MOARbots/MOARbots-parts/Compound-Gear-Cart/motorassembly.jpg

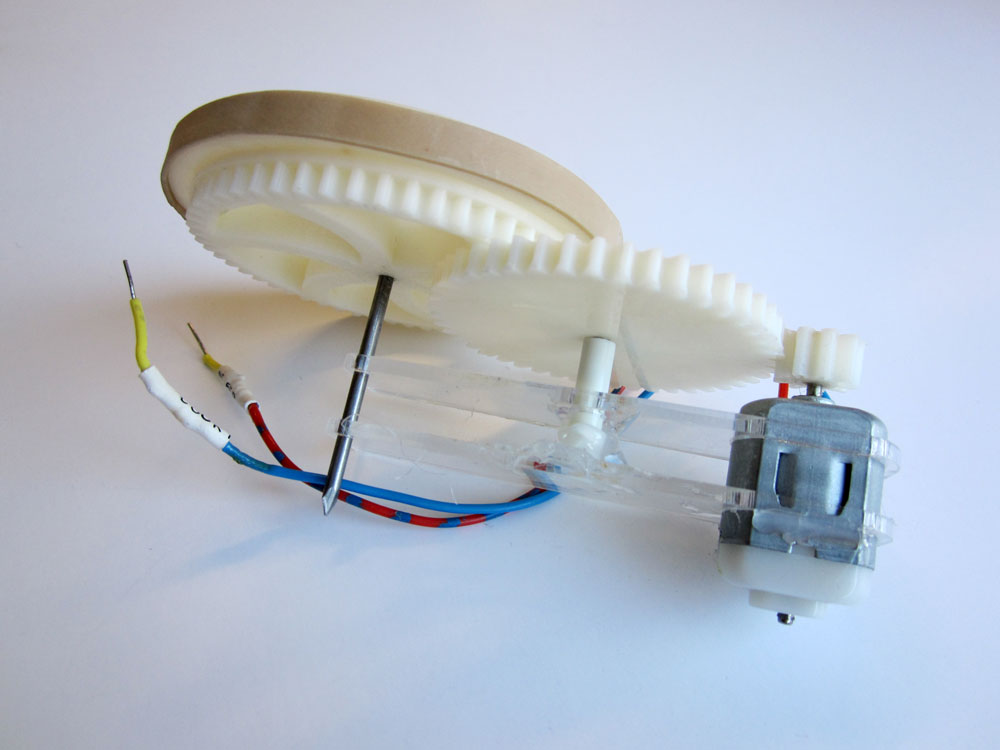
Compound-Gear-Cart/motorassembly.jpg
