MOARbots/MOARbots-parts/Compound-Gear-Cart/parts.jpg

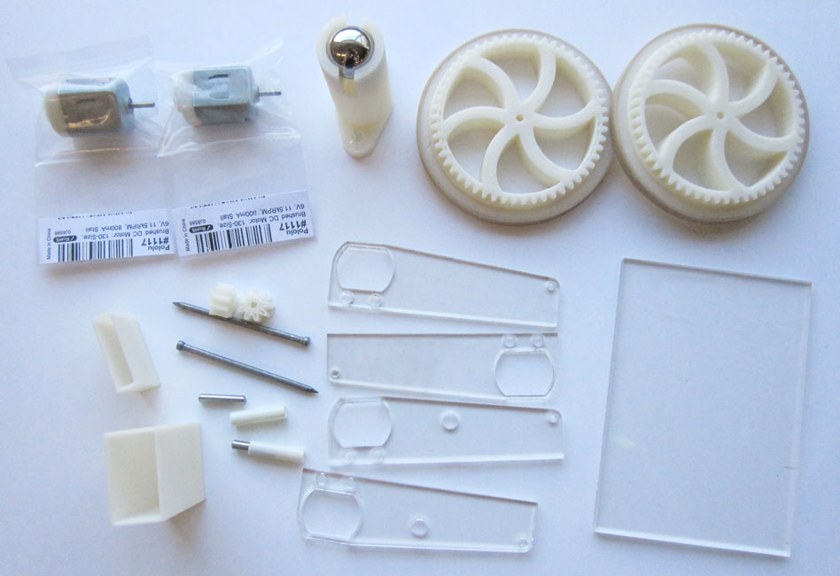
Compound-Gear-Cart/parts.jpg
