MOARbots/MOARbots-parts/Compound-Gear-Cart/Example.JPG

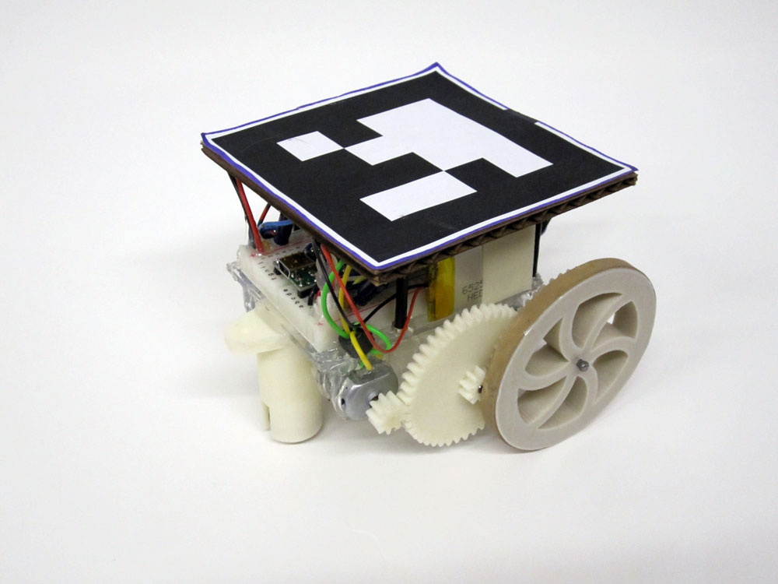
Compound-Gear-Cart/Example.JPG
