MOARbots/MOARbots-parts/Omniwheel/Old/omnipositive.stl

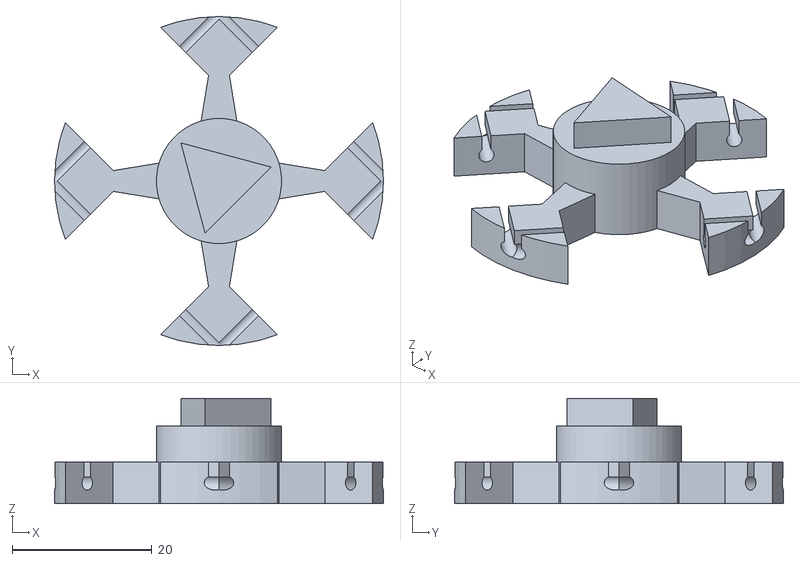
[picture p4: CAD file, 2015-04-01, an earlier design]
Omniwheel/Old/omnipositive.stl
47.2 x 47.2 x 15.1
