MOARbots/MOARbots-parts/Omniwheel/Old/omninegative.stl

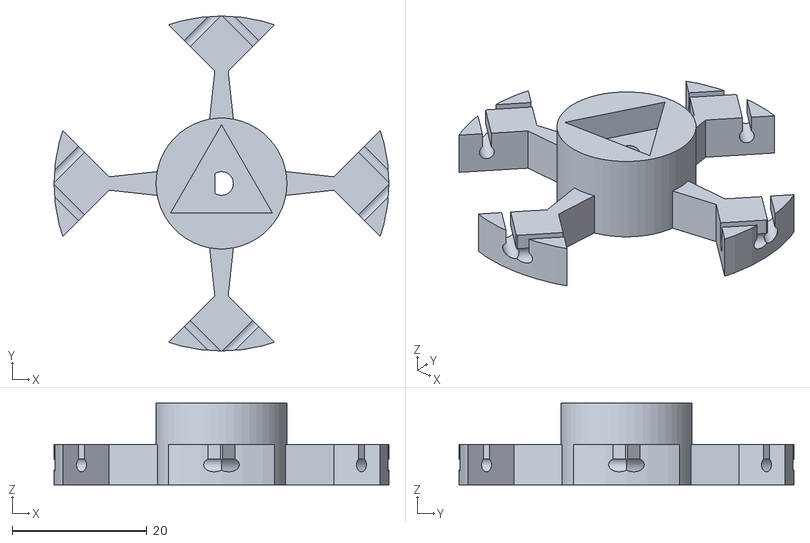
[picture p5: CAD file, 2015-04-01, an earlier design]
Omniwheel/Old/omninegative.stl
49.8 x 49.8 x 12.2
