MOARbots/MOARbots-parts/Omniwheel/Old/omnibead.stl

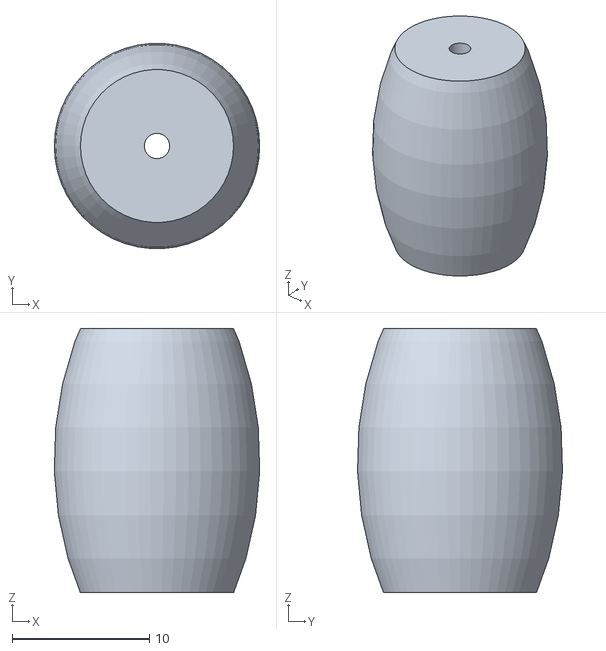
[picture p6: CAD file, 2015-04-01, an earlier design]
Omniwheel/Old/omnibead.stl
15.0 x 15.0 x 19.3
