MOARbots/MOARbots-parts/(list of files, cad)

Other CAD files:
Compound-Gear-Cart/parametric_involute_gear_v5.0.scad
Compound-Gear-Cart/small_gear.scad
Compound-Gear-Cart/smallbatteryholder.scad
Compound-Gear-Cart/wheel.scad
Omniwheel/Old/omniwheel-nogear.scad
Omniwheel/Old/omniwheel-nogear2.scad
Omniwheel/Old/omniwheel.scad
