MOARbots/MOARbots-parts/(commit log)

2015-02-12 Cart redesign--smaller main battery, single plate, new motor mount, and compound gear.
    [compound.scad, largebatteryholder.scad, motormount.scad]
2015-03-31 Renamed cart
    [BallCaster.scad, compound.scad, largebatteryholder.scad, minicart_hybrid_gear_wheel.scad, minicart_small_gear.scad, motormount.scad, parametric_involute_gear_v5.0.scad, smallbatteryholder.scad]
2015-03-31 Added README and renamed some files.
    [BallCaster.scad, small_gear.scad, wheel.scad]
2015-03-31 Added photo of parts and motor assembly.
2015-04-01 Omniwheel resources initial commit. Halfway through cleanup of files.
    [bead.scad, hub.scad, omnibead.stl, omninegative.stl, omnipositive.stl, omniwheel-nogear.scad, omniwheel-nogear2.scad, omniwheel.scad]
